SebyR/SmartPosture/Poze/PozaMontaj1.jpeg

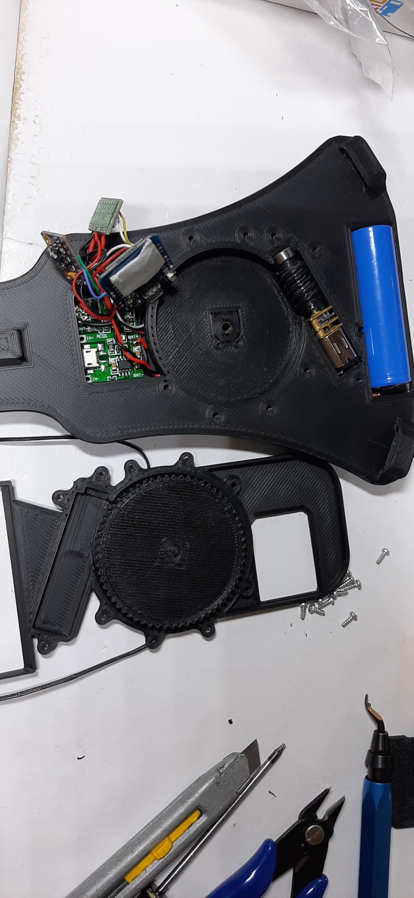
Poze/PozaMontaj1.jpeg
