SebyR/SmartPosture/Poze/PozaMontaj2.jpeg

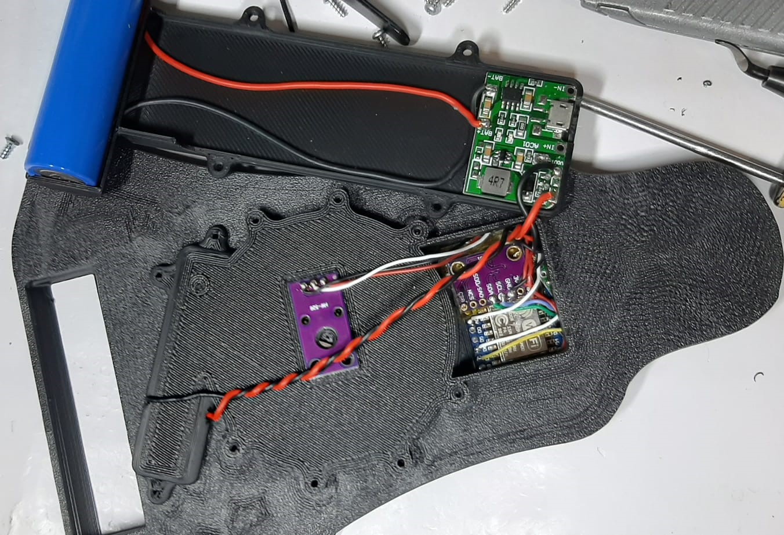
Poze/PozaMontaj2.jpeg
