SebyR/SmartPosture/README.md

# SmartPosture
SmartPosture este un dispozitiv menit sa ajute la corectarea posturii
