SebyR/SmartPosture/Documentatie/SmartPostureSchema.png

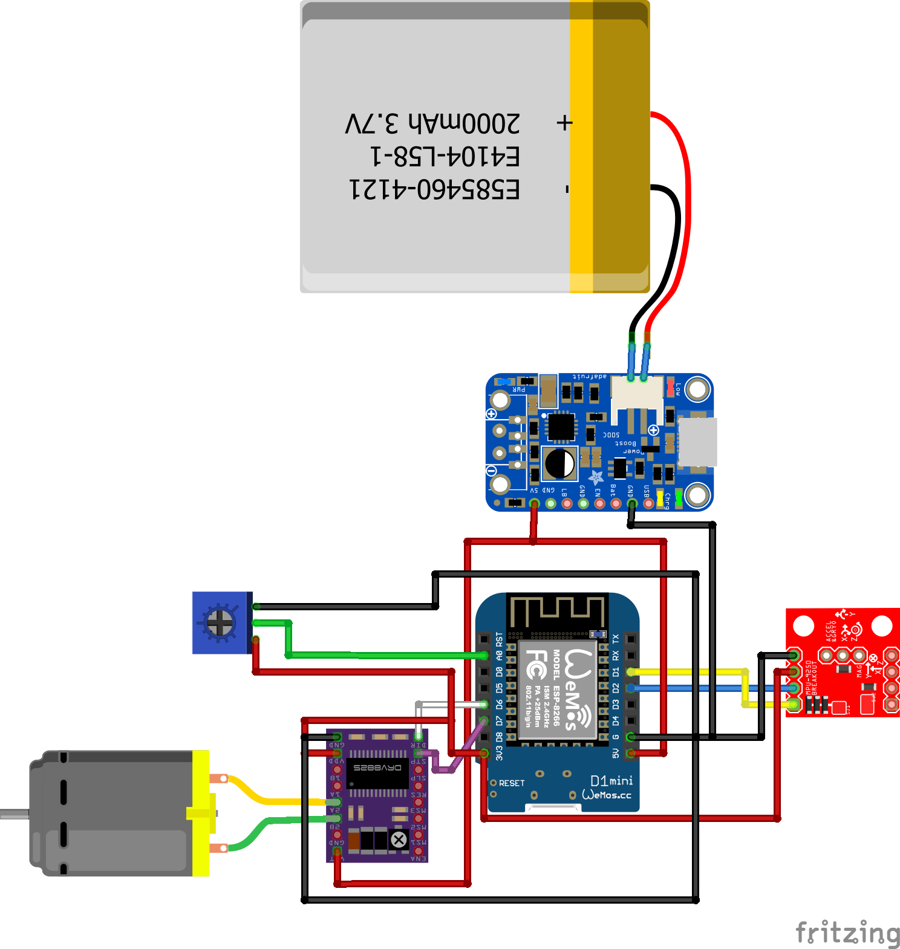
Documentatie/SmartPostureSchema.png
