SebyR/SmartPosture/Poze/AppDarkM.jpg

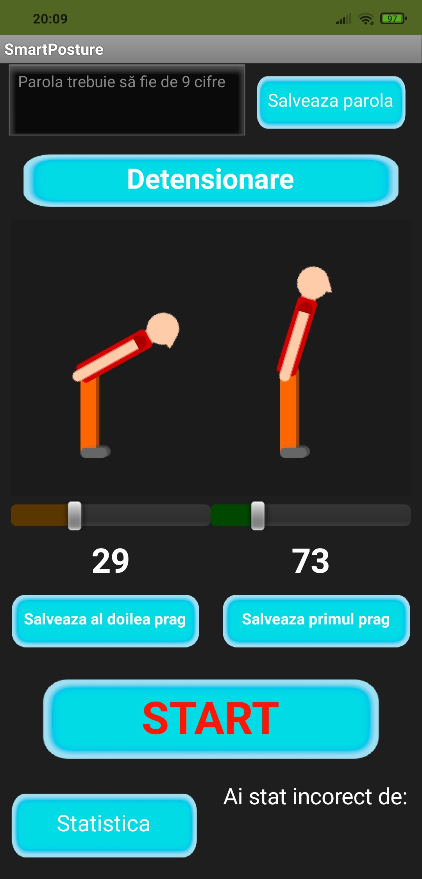
Poze/AppDarkM.jpg
