SebyR/SmartPosture/Poze/CodApp.jpg

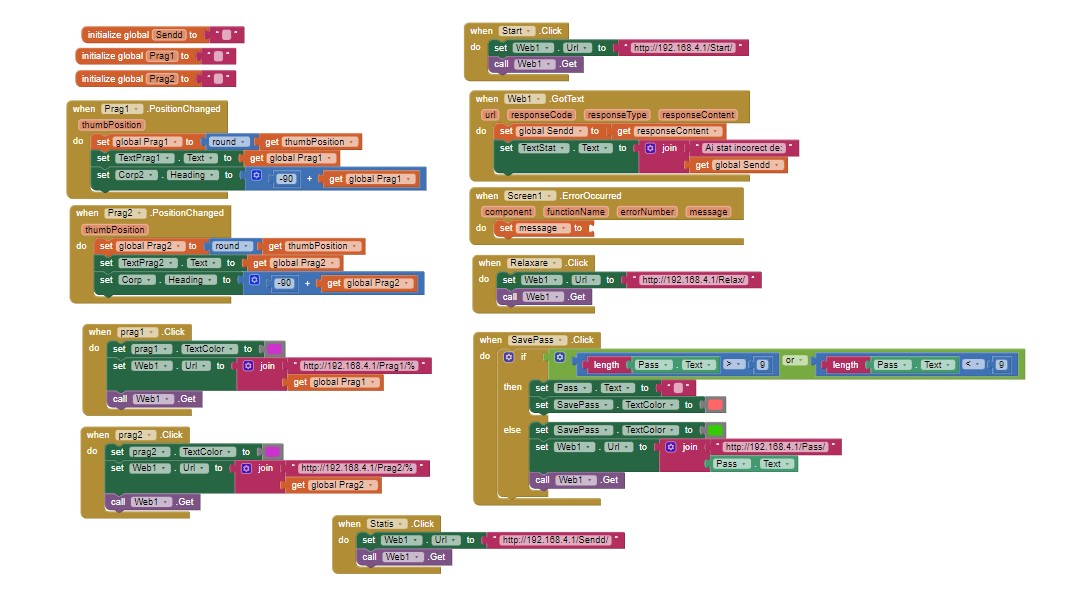
Poze/CodApp.jpg
