SebyR/SmartPosture/Poze/PozaMintaj3.jpeg

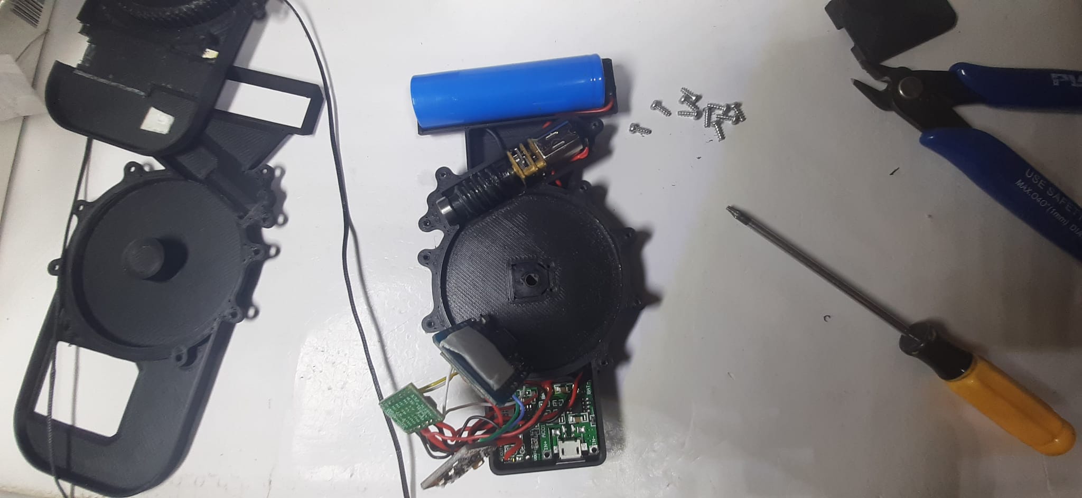
Poze/PozaMintaj3.jpeg
