SebyR/SmartPosture/Poze/Randare1.png

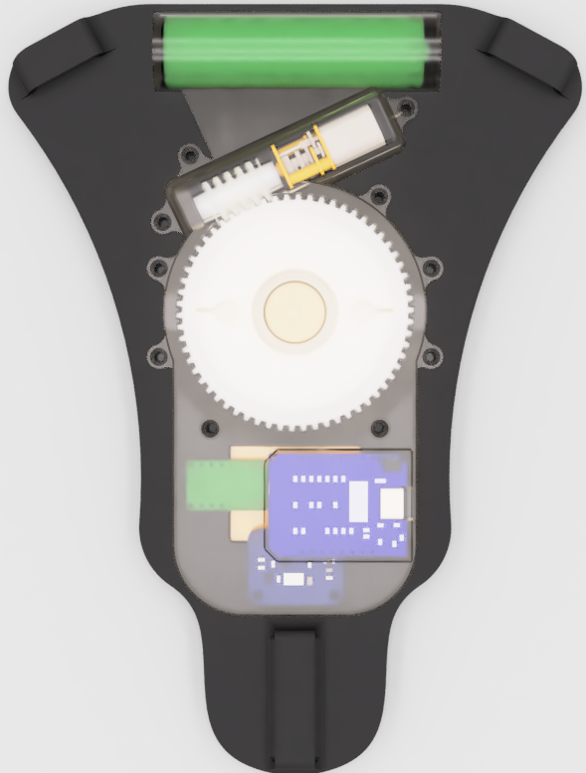
Poze/Randare1.png
