SebyR/SmartPosture/Poze/SmartPosture.jpeg

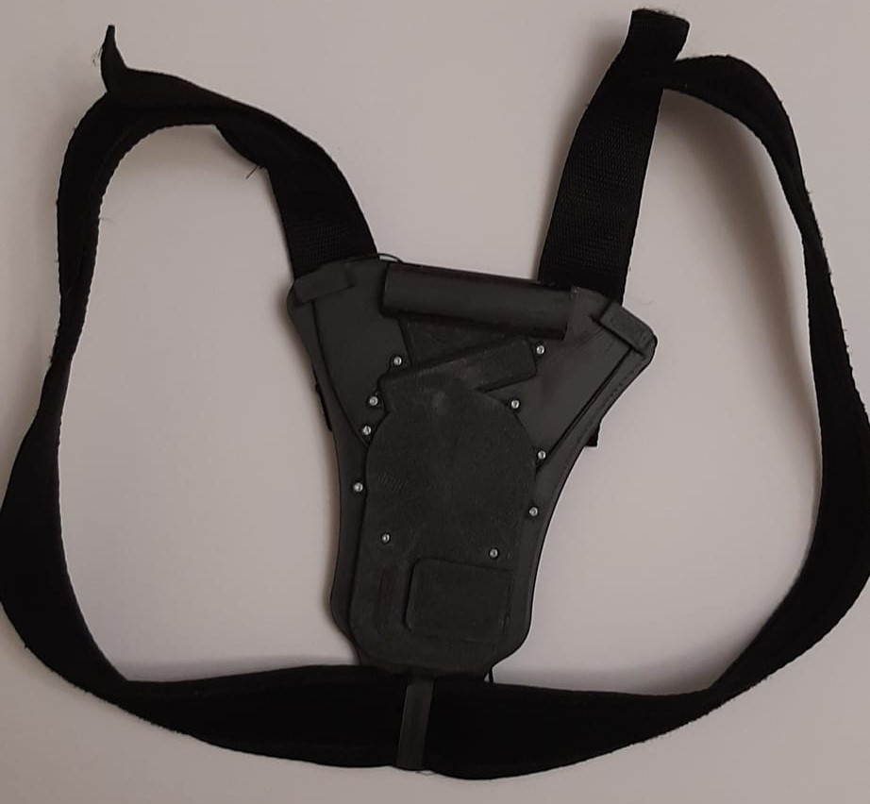
Poze/SmartPosture.jpeg
