SebyR/SmartPosture/Poze/SmartPosture.png

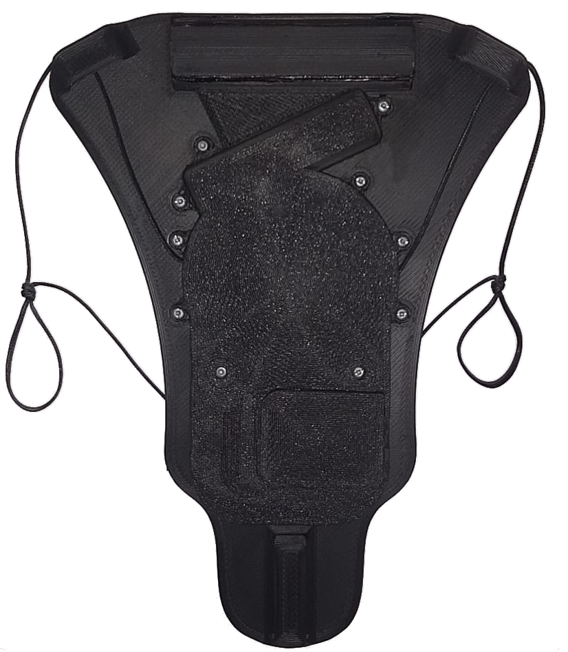
Poze/SmartPosture.png
