SebyR/SmartPosture/Stl-uri/Capac Esp.stl

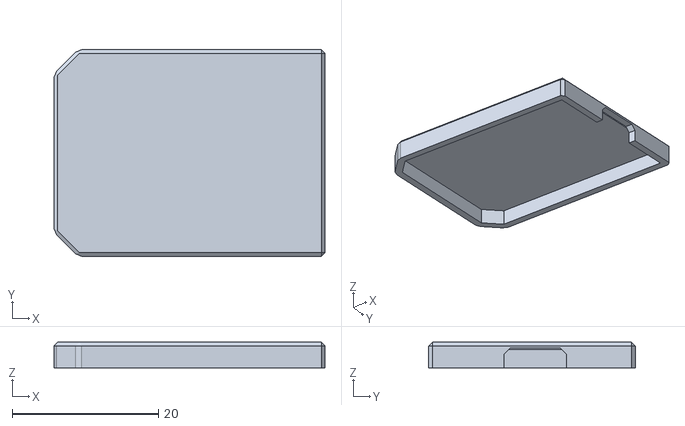
[picture p21: CAD file, 2022-07-05]
Stl-uri/Capac Esp.stl
37.1 x 28.3 x 3.50
