SebyR/SmartPosture/Stl-uri/Worm_gear.stl

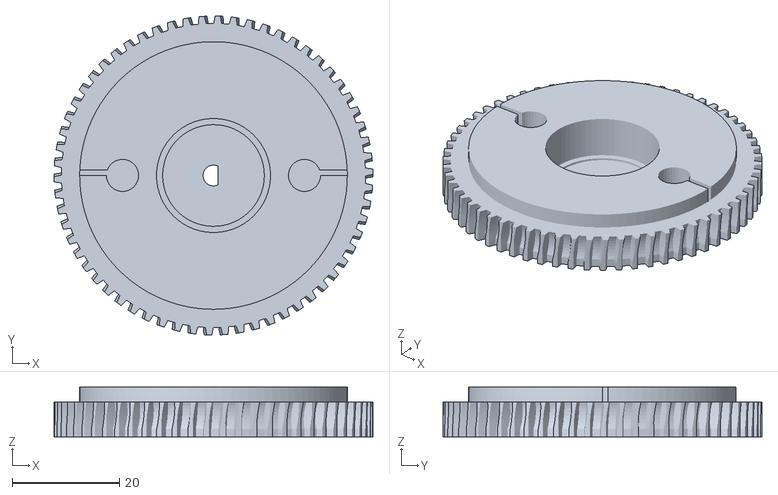
[picture p22: CAD file, 2022-07-05]
Stl-uri/Worm_gear.stl
59.6 x 59.6 x 9.30
