SebyR/SmartPosture/Stl-uri/Baza.stl

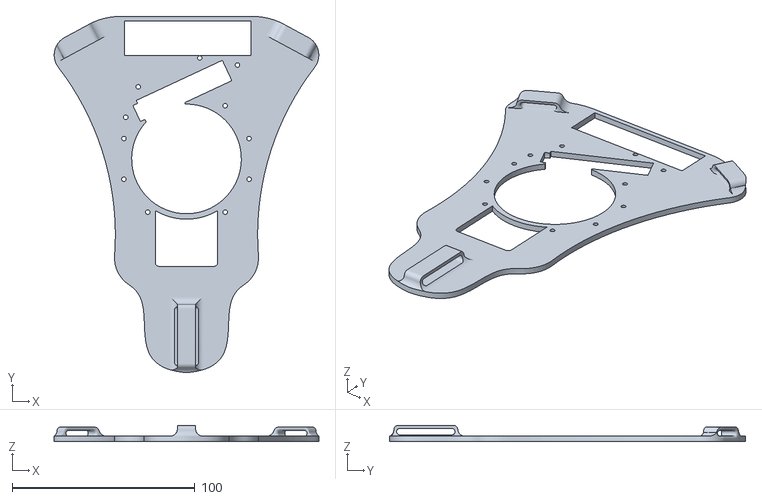
[picture p23: CAD file, 2022-07-05]
Stl-uri/Baza.stl
144.8 x 194.8 x 9.00
