SebyR/SmartPosture/Stl-uri/Capac_batt.stl

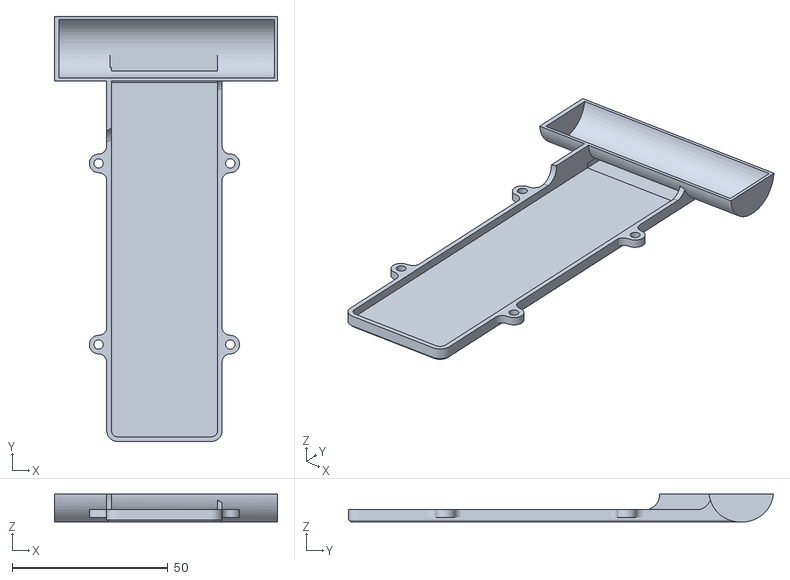
[picture p24: CAD file, 2022-07-05]
Stl-uri/Capac_batt.stl
71.8 x 136.6 x 9.00
