SebyR/SmartPosture/Stl-uri/Capac (1).stl

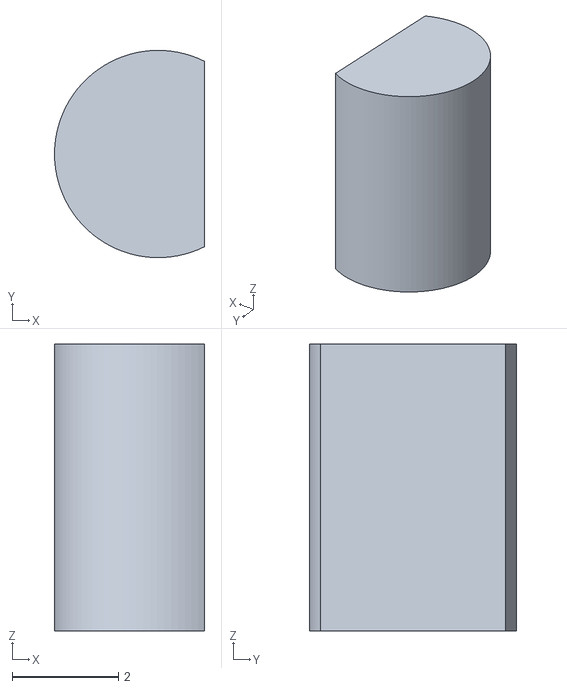
[picture p25: CAD file, 2022-07-05]
Stl-uri/Capac (1).stl
2.82 x 3.90 x 5.40
