SebyR/SmartPosture/Stl-uri/Capac_fata.stl

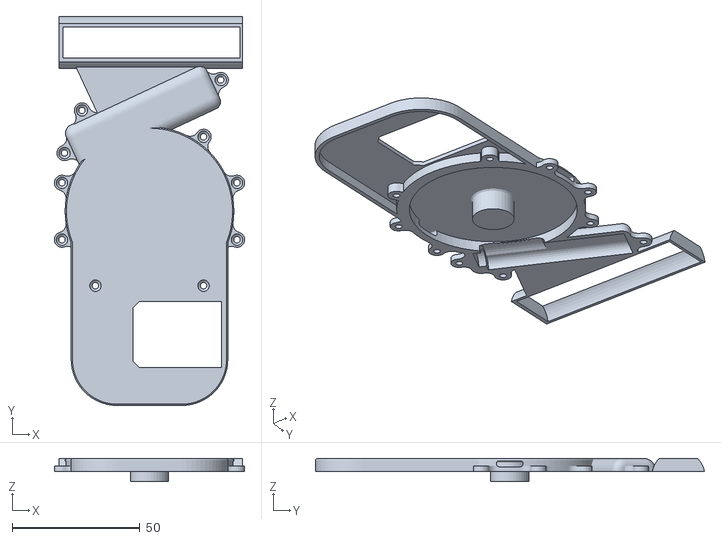
[picture p26: CAD file, 2022-07-05]
Stl-uri/Capac_fata.stl
74.5 x 152.2 x 9.00
