SebyR/SmartPosture/Stl-uri/Worm.stl

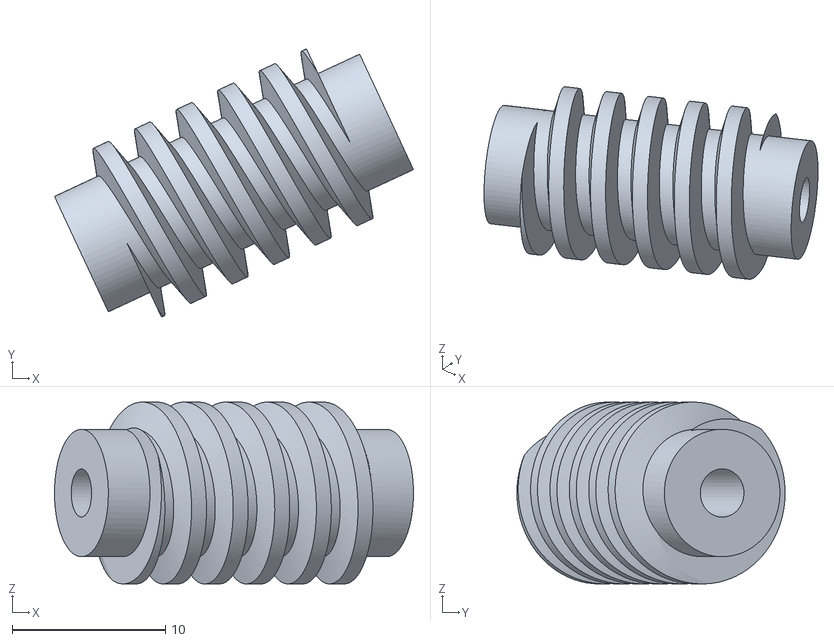
[picture p27: CAD file, 2022-07-05]
Stl-uri/Worm.stl
23.5 x 17.5 x 11.9
