SebyR/SmartPosture/Stl-uri/Capac_spate.stl

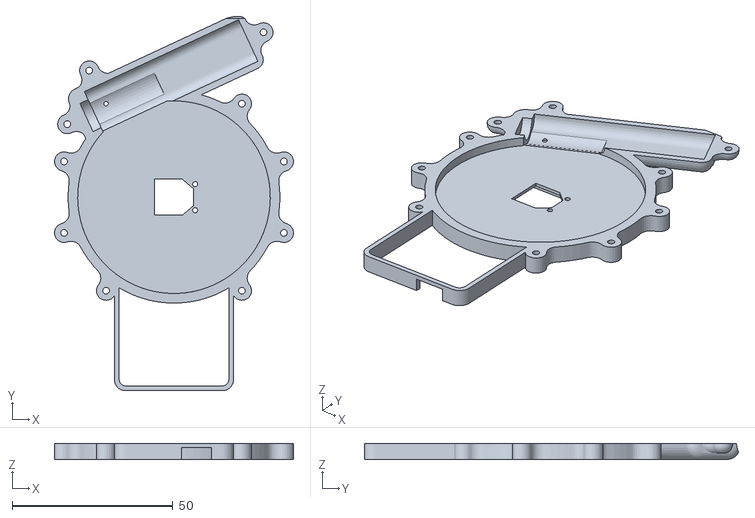
[picture p28: CAD file, 2022-07-05]
Stl-uri/Capac_spate.stl
74.5 x 116.6 x 5.00
