SebyR/SmartPosture/Stl-uri/Capac_fata (1).stl

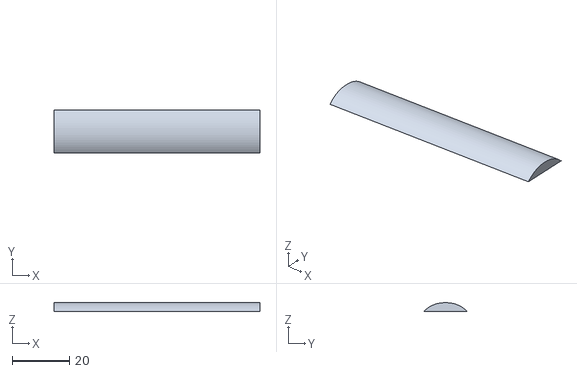
[picture p29: CAD file, 2022-07-05, an earlier design]
Stl-uri/Capac_fata (1).stl
71.8 x 15.1 x 3.00
