SebyR/SmartPosture/Poze/PozaMontaj3.jpeg

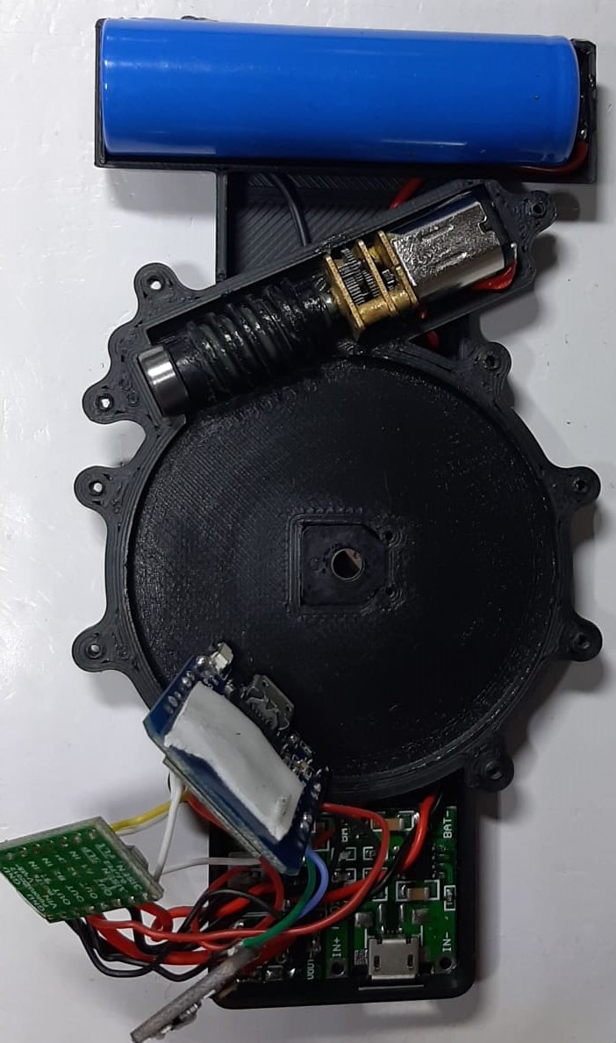
Poze/PozaMontaj3.jpeg
